elehobica/SocksWarmerVoltageControl/doc/SocksWarmerVoltageControl.pdf

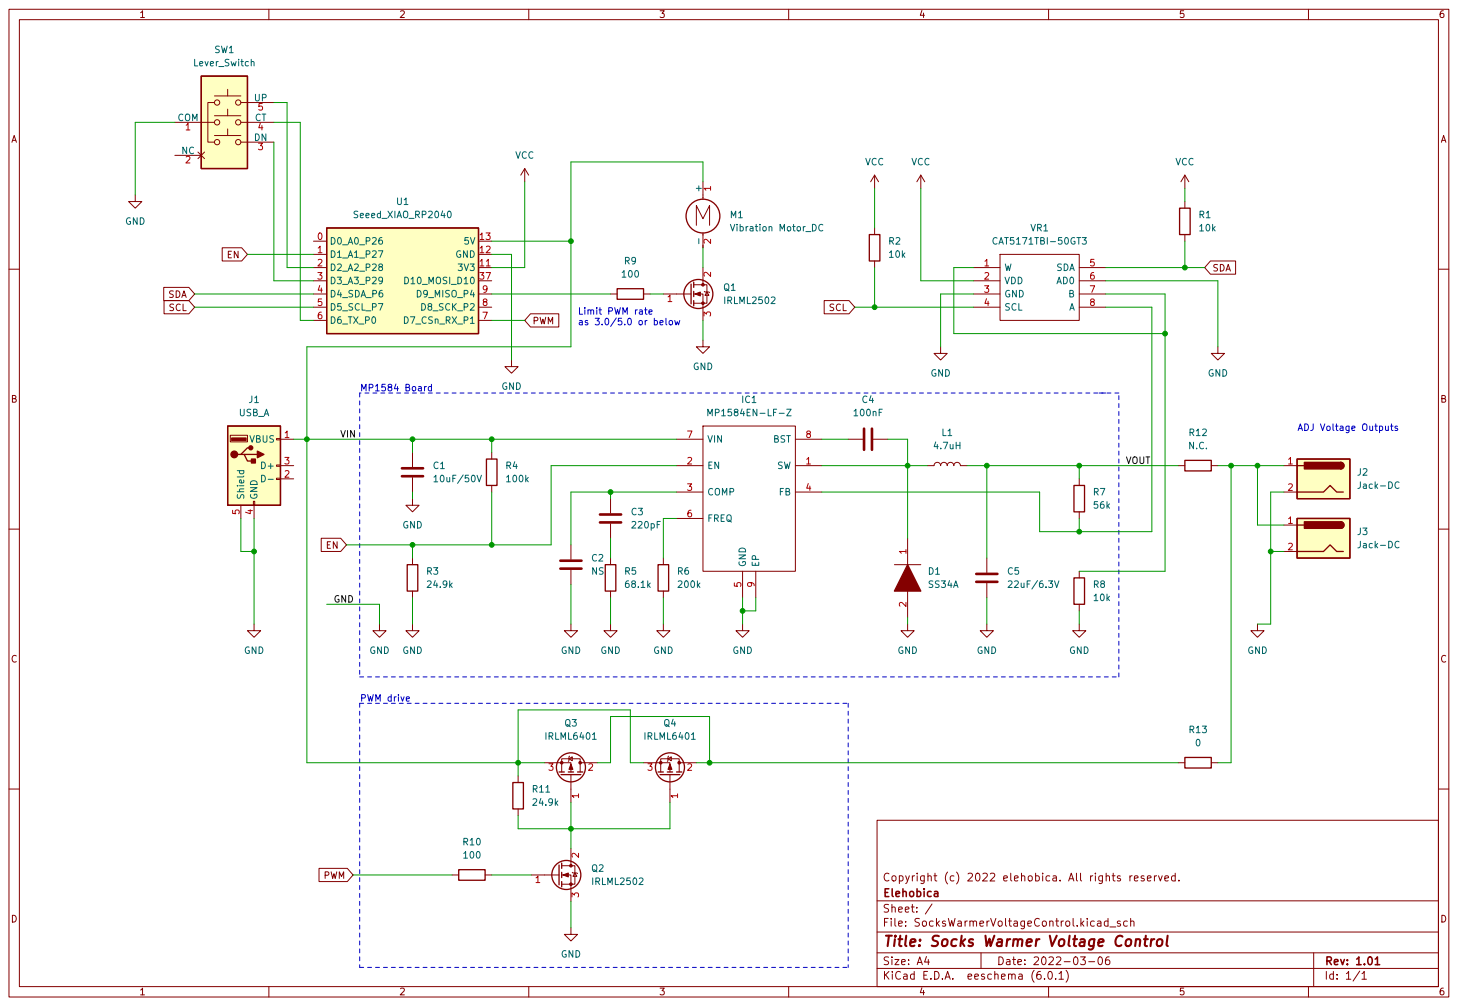
[picture p2: page 1]

SCL PWM
as 3.0/5.0 or below MP1584 Board PWM drive

5 FREQ 6 VIN 7 BST 8 EP

IRLML6401 GND

File: SocksWarmerVoltageControl.kicad_sch Sheet: / Elehobica Copyright (c) 2022 elehobica. All rights reserved. GND

Id: 1/1 Title: Socks Warmer Voltage Control
