elehobica/SocksWarmerVoltageControl/(commit log)

2022-01-23 add image and schematic
2022-02-13 support Vibration Motor to notify user switch control
    [SocksWarmerVoltageControl.ino]
2022-02-20 add Pwm VoltageController
2022-03-01 add Pwm schematic
2022-03-01 change to PwmSignal class to avoid conflict when Seeeduino XIAO
    [PwmSignal.cpp, PwmSignal.h, SocksWarmerVoltageControl.ino]
